bonkas/AmigaFloppytoPC/Amiga Floppy Bridge v2 (Discrete).kicad_pcb

## KiCad design Amiga Floppy Bridge v2 (Discrete).kicad_pcb (2021-06-22)

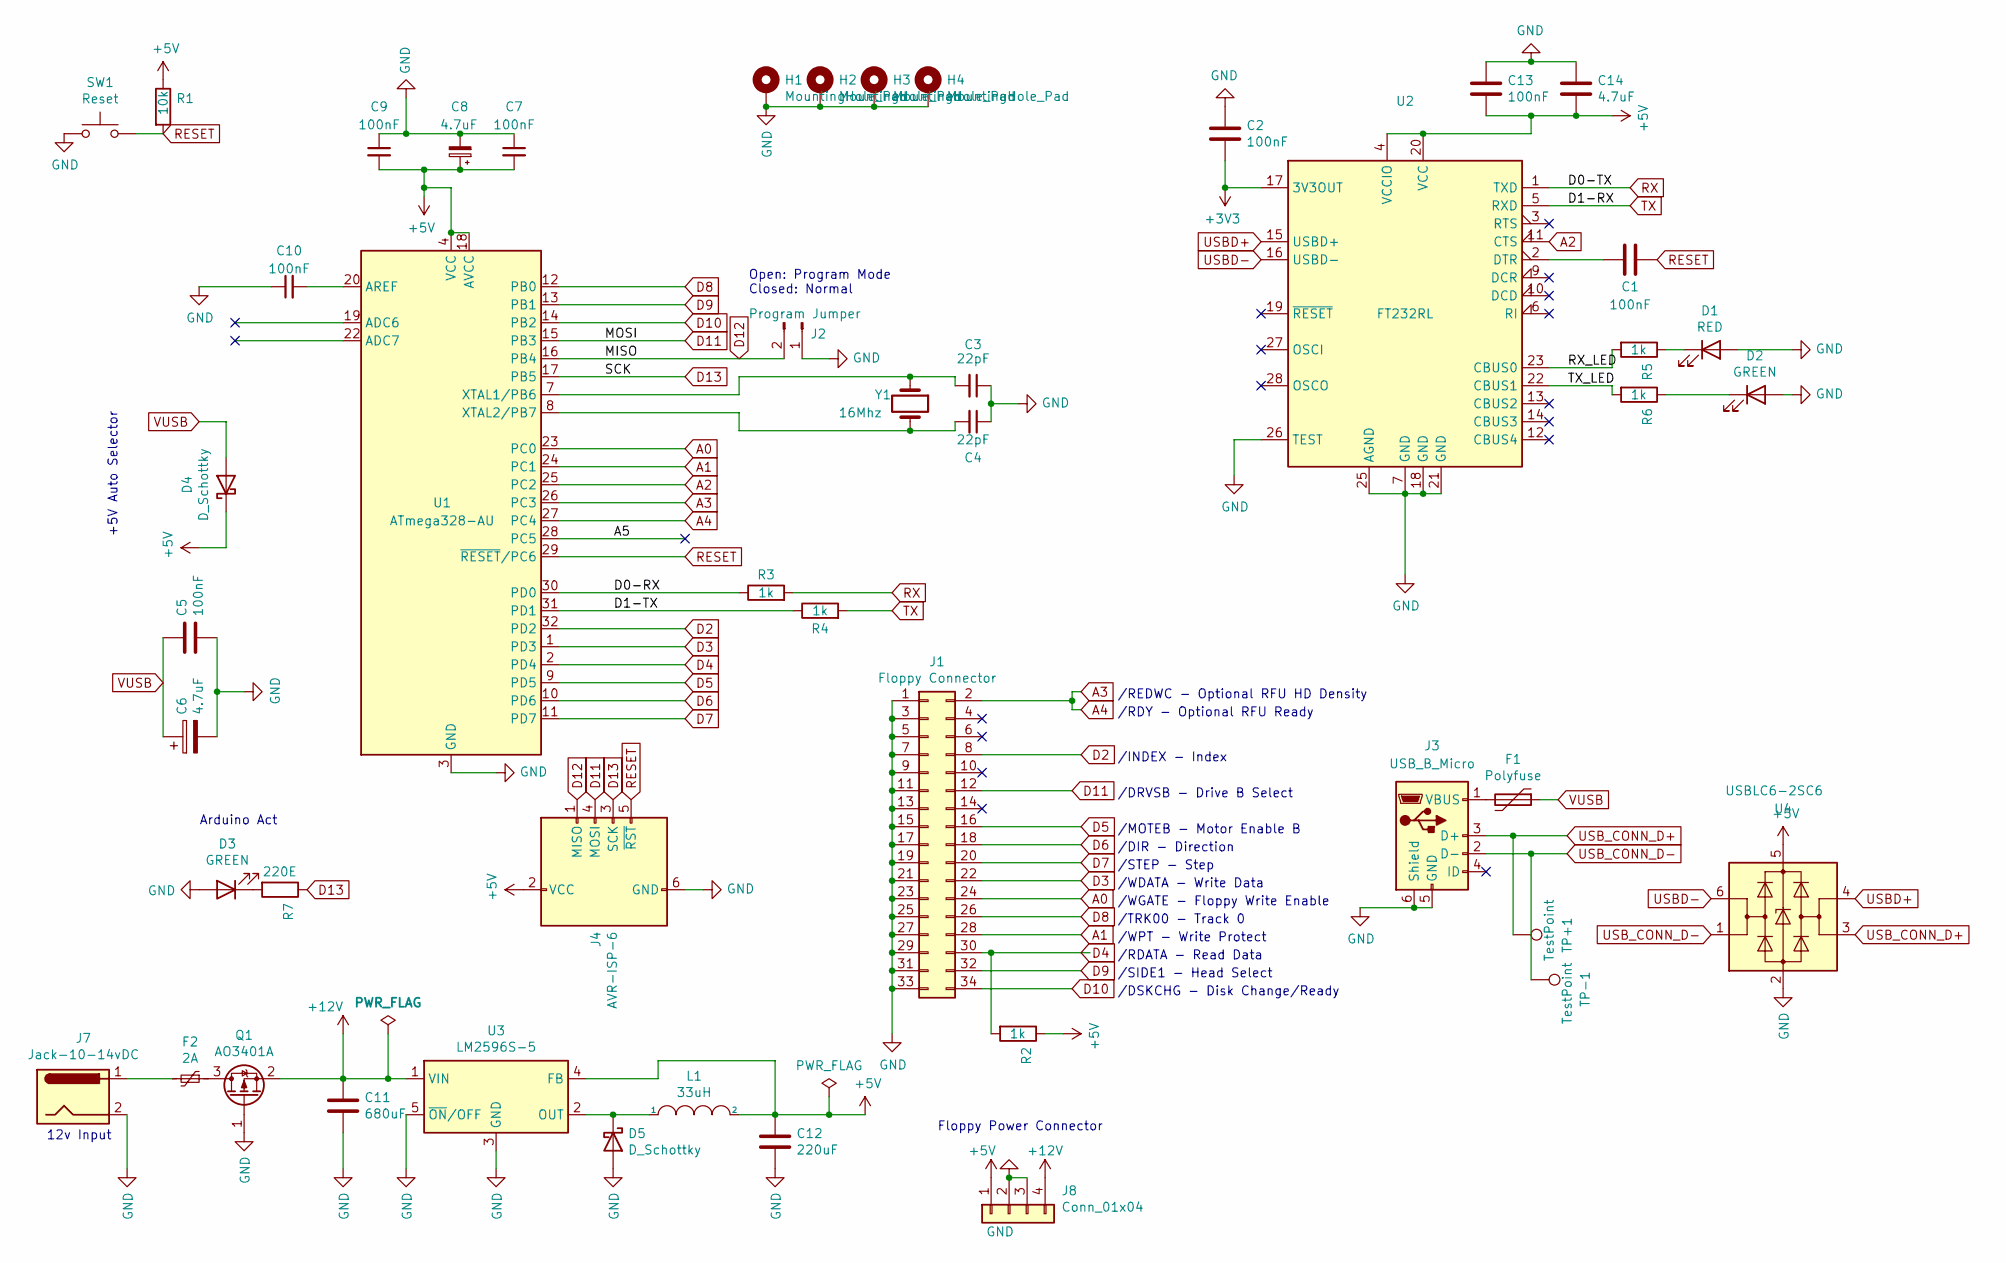
[picture p1: schematic Amiga Floppy Bridge v2 (Discrete).sch, Arduino Floppy Bridge]

Parts:
C1, C2, C5, C7, C9, C10, C13: 100nF; C_0805_2012Metric_Pad1.18x1.45mm_HandSolder; LCSC Part C49678
C3, C4: 22pF; C_0805_2012Metric_Pad1.18x1.45mm_HandSolder; LCSC Part C1804
C6, C8, C14: 4.7uF; C_0805_2012Metric_Pad1.18x1.45mm_HandSolder; LCSC Part C1779
C11: 680uF; CP_Elec_10x10; LCSC Part C249562
C12: 220uF; CP_Elec_6.3x7.7; LCSC Part C127327
D1: RED; LED_0201_0603Metric_Pad0.64x0.40mm_HandSolder; LCSC Part C2286
D2, D3: GREEN; LED_0201_0603Metric_Pad0.64x0.40mm_HandSolder; LCSC Part C72043
D4: D_Schottky; D_SMA-SMB_Universal_Handsoldering; LCSC Part C64989
D5: D_Schottky; D_SMA-SMB_Universal_Handsoldering; LCSC Part C22452
F1: Polyfuse; Fuse_0805_2012Metric_Pad1.15x1.40mm_HandSolder; LCSC Part C70061
F2: 2A; Fuse_1812_4532Metric; LCSC Part C69691
H1, H2, H3, H4: MountingHole_Pad; MountingHole_3.2mm_M3_Pad_Via
J1: Floppy Connector; PinHeader_2x17_P2.54mm_Vertical
J2: Program Jumper; PinHeader_1x02_P2.54mm_Vertical
J3: USB_B_Micro; USB_Micro-B_Molex_47346-0001; LCSC Part C132560
J4: AVR-ISP-6; PinHeader_2x03_P2.54mm_Vertical
J7: Jack-10-14vDC; BarrelJack_Wuerth_6941xx301002
J8: Conn_01x04; PinHeader_1x04_P2.54mm_Vertical
L1: 33uH; YSPI1365-470M; LCSC Part C329385
Q1: AO3401A; SOT-23
R1: 10k; R_0805_2012Metric_Pad1.20x1.40mm_HandSolder; LCSC Part C17414
R2, R3, R4, R5, R6: 1k; R_0805_2012Metric_Pad1.20x1.40mm_HandSolder; LCSC Part C17513
R7: 220E; R_0805_2012Metric_Pad1.20x1.40mm_HandSolder; LCSC Part C17557
SW1: Reset; SW_PUSH_6mm
TP+1: TestPoint
TP-1: TestPoint
U1: ATmega328-AU; TQFP-32_7x7mm_P0.8mm
U2: FT232RL; SSOP-28_5.3x10.2mm_P0.65mm
U3: LM2596S-5; TO-263-5_TabPin3; LCSC Part C347421
U4: USBLC6-2SC6; SOT-23-6; LCSC Part C7519
Y1: 16Mhz; Crystal_SMD_2520-4Pin_2.5x2.0mm

Connections:
+3V3: C2.1, U2.17 (3V3OUT)
+5V: C7.2, C8.1, C9.2, C12.1, C13.1, C14.1, D4.1 (K), J4.2 (VCC), J8.1, L1.2, R1.1, R2.1, U1.4 (VCC), U1.6 (VCC), U1.18 (AVCC), U2.4 (VCCIO), U2.20 (VCC), U3.4 (FB), U4.5 (VBUS)
+12V: C11.1, J8.4, Q1.2 (S), U3.1 (VIN)
/A5: U1.28 (PC5)
/D0-RX: R3.1, U1.30 (PD0)
/D1-TX: R4.1, U1.31 (PD1)
/RX_LED: R5.2, U2.23 (CBUS0)
/TX_LED: R6.2, U2.22 (CBUS1)
A0: J1.24, U1.23 (PC0)
A1: J1.28, U1.24 (PC1)
A2: U1.25 (PC2), U2.11 (CTS)
A3: J1.2, U1.26 (PC3), U1.27 (PC4)
D2: J1.8, U1.32 (PD2)
D3: J1.22, U1.1 (PD3)
D4: J1.30, R2.2, U1.2 (PD4)
D5: J1.16, U1.9 (PD5)
D6: J1.18, U1.10 (PD6)
D7: J1.20, U1.11 (PD7)
D8: J1.26, U1.12 (PB0)
D9: J1.32, U1.13 (PB1)
D10: J1.34, U1.14 (PB2)
D11: J1.12, J4.4 (MOSI), U1.15 (PB3)
D12: J2.2, J4.1 (MISO), U1.16 (PB4)
D13: J4.3 (SCK), R7.1, U1.17 (PB5)
GND: C2.2, C3.1, C4.1, C5.2, C6.2, C7.1, C8.2, C9.1, C10.1, C11.2, C12.2, C13.2, C14.2, D1.2 (A), D2.2 (A), D3.2 (A), D5.2 (A), H1.1, H2.1, H3.1, H4.1, J1.1, J1.3, J1.5, J1.7, J1.9, J1.11, J1.13, J1.15, J1.17, J1.19, J1.21, J1.23, J1.25, J1.27, J1.29, J1.31, J1.33, J2.1, J3.5 (GND), J3.6 (Shield), J4.6 (GND), J7.2, J8.2, J8.3, Q1.1 (G), SW1.1, U1.3 (GND), U1.5 (GND), U1.21 (GND), U2.7 (GND), U2.18 (GND), U2.21 (GND), U2.25 (AGND), U2.26 (TEST), U3.3 (GND), U3.5 (~ON~/OFF), U4.2 (GND)
unnamed: C1.2, U2.2 (DTR)
unnamed: C3.2, U1.7 (XTAL1/PB6), Y1.1
unnamed: C4.2, U1.8 (XTAL2/PB7), Y1.2
unnamed: C10.2, U1.20 (AREF)
unnamed: D1.1 (K), R5.1
unnamed: D2.1 (K), R6.1
unnamed: D3.1 (K), R7.2
unnamed: D5.1 (K), L1.1, U3.2 (OUT)
unnamed: F1.2, J3.1 (VBUS)
unnamed: F2.1, Q1.3 (D)
unnamed: F2.2, J7.1
RESET: C1.1, J4.5 (~RST), R1.2, SW1.2, U1.29 (~RESET~/PC6)
RX: R3.2, U2.1 (TXD)
TX: R4.2, U2.5 (RXD)
USBD+: U2.15 (USBD+), U4.4 (I/O2)
USBD-: U2.16 (USBD-), U4.6 (I/O1)
USB_CONN_D+: J3.3 (D+), TP+1.1, U4.3 (I/O2)
USB_CONN_D-: J3.2 (D-), TP-1.1, U4.1 (I/O1)
VUSB: C5.1, C6.1, D4.2 (A), F1.1

Notes on the sheet:
Open: Program Mode Closed: Normal
+5V Auto Selector
/INDEX - Index
/DRVSB - Drive B Select
/MOTEB - Motor Enable B
/DIR - Direction
/STEP - Step
/WDATA - Write Data
/WGATE - Floppy Write Enable
/TRK00 - Track 0
/WPT - Write Protect
/RDATA - Read Data
/SIDE1 - Head Select
/DSKCHG - Disk Change/Ready
/REDWC - Optional RFU HD Density
/RDY - Optional RFU Ready
12v Input
Floppy Power Connector
Arduino Act

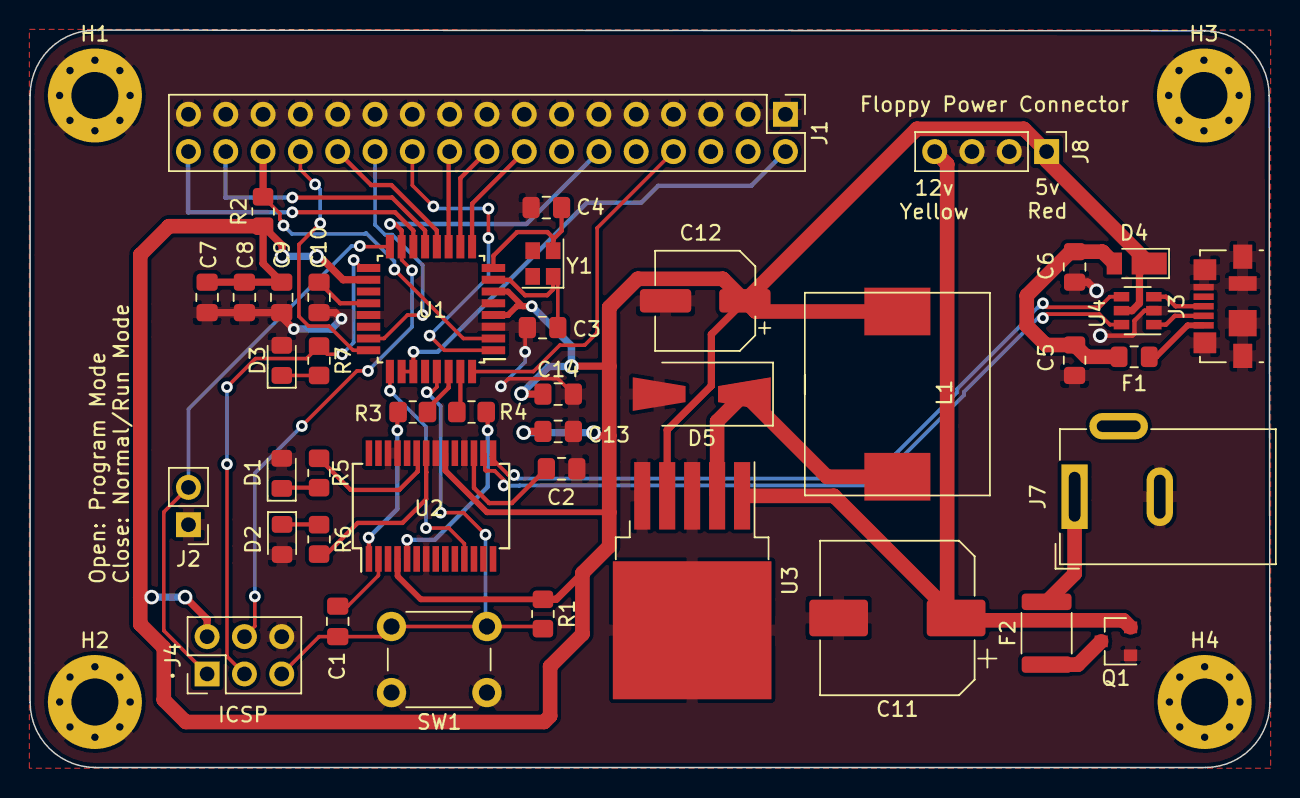
[picture p2: board Amiga Floppy Bridge v2 (Discrete).kicad_pcb from above]

Board: 2 copper layers, 84.4 x 50.2 mm, 46 parts (0 on the bottom side), 43 nets.
